Agilack/cowdin-3b-esp32/README.md

CowDIN ESP32
============

This project is an electronic module to add wifi or bluetooth connectivity into
a DIN enclosure (size 3U).

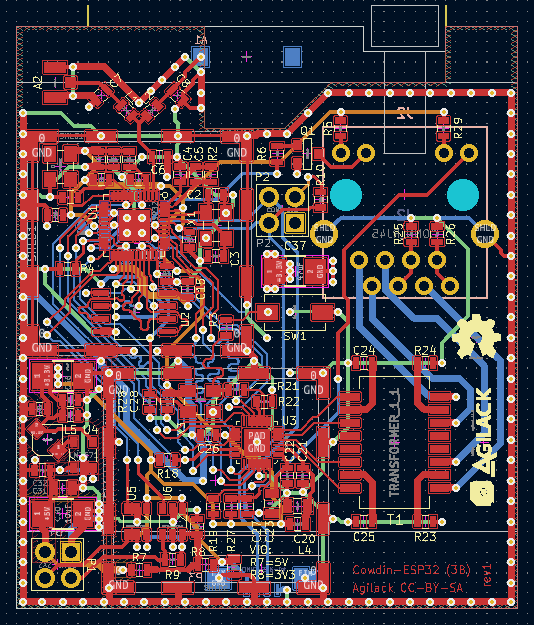
[picture p1: hardware/doc/kicad-routing-preview.png]
Preview of PCB Wip
