Agilack/cowdin-3b-esp32/(commit log)

2022-05-17 --=={ Create Project }==--
    [cowdin-3b-esp32.kicad_pcb, cowdin-3b-esp32.kicad_sch, mcu.kicad_sch]
2022-05-18 Hardware: Add shield cabinet over ESP32, and insert 32kHz oscillator for RTC
    [cowdin-3b-esp32.kicad_pcb, cowdin-3b-esp32.kicad_sch, mcu.kicad_sch]
2022-05-19 Hardware: Add ethernet interface (Wip), fix shield cabinet size and position
    [cowdin-3b-esp32.kicad_pcb, cowdin-3b-esp32.kicad_sch, ethernet.kicad_sch, mcu.kicad_sch]
2022-05-20 Hardware: Improve ethernet interface, add routing for RMII
    [cowdin-3b-esp32.kicad_pcb, cowdin-3b-esp32.kicad_sch, ethernet.kicad_sch, mcu.kicad_sch]
2022-05-21 Hardware: Add power supply, uart interfaces and create production files for rev1
    [cowdin-3b-esp32-B_Cu.gbr, cowdin-3b-esp32-B_Mask.gbr, cowdin-3b-esp32-B_Paste.gbr, cowdin-3b-esp32-B_Silkscreen.gbr, cowdin-3b-esp32-Edge_Cuts.gbr, cowdin-3b-esp32-F_Cu.gbr, cowdin-3b-esp32-F_Mask.gbr, cowdin-3b-esp32-F_Paste.gbr]
