Agilack/cowdin-3b-esp32/(notices)

Notices in the files:
hardware/prj-kicad/cowdin-3b-esp32.kicad_pcb:
License: CC-by-SA
Agilack CC-BY-SA
